duncathan/cs207proj/img/smashbox_schem.png

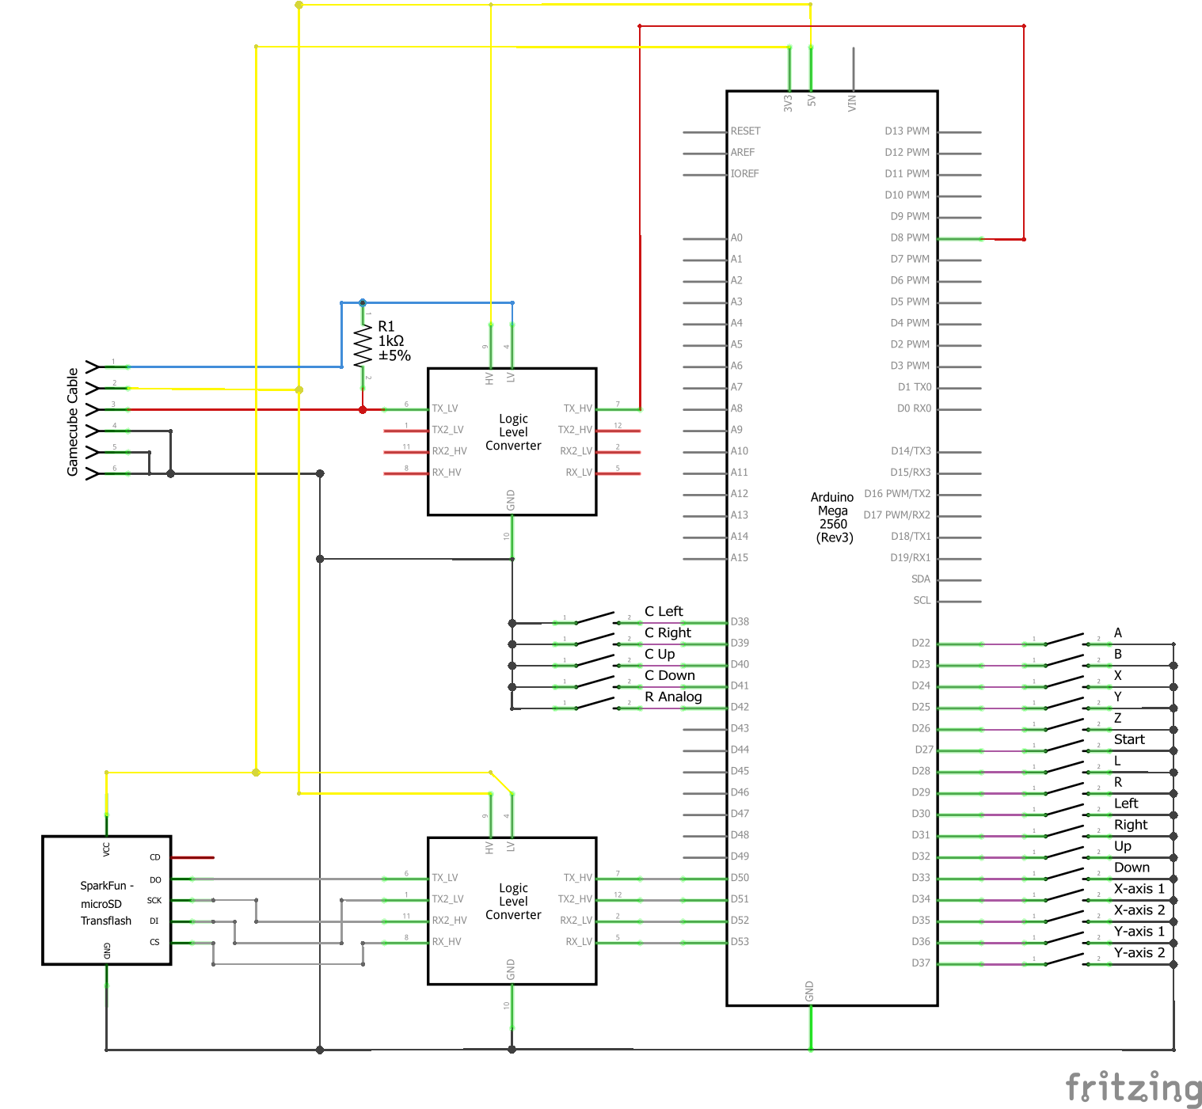
img/smashbox_schem.png
