duncathan/cs207proj/(list of files, drawings)

Other design files:
hardware/smashbox.fzz
