duncathan/cs207proj/hardware/eagle/sboxs.brd

## EAGLE design hardware/eagle/sboxs.brd (2018-03-08)

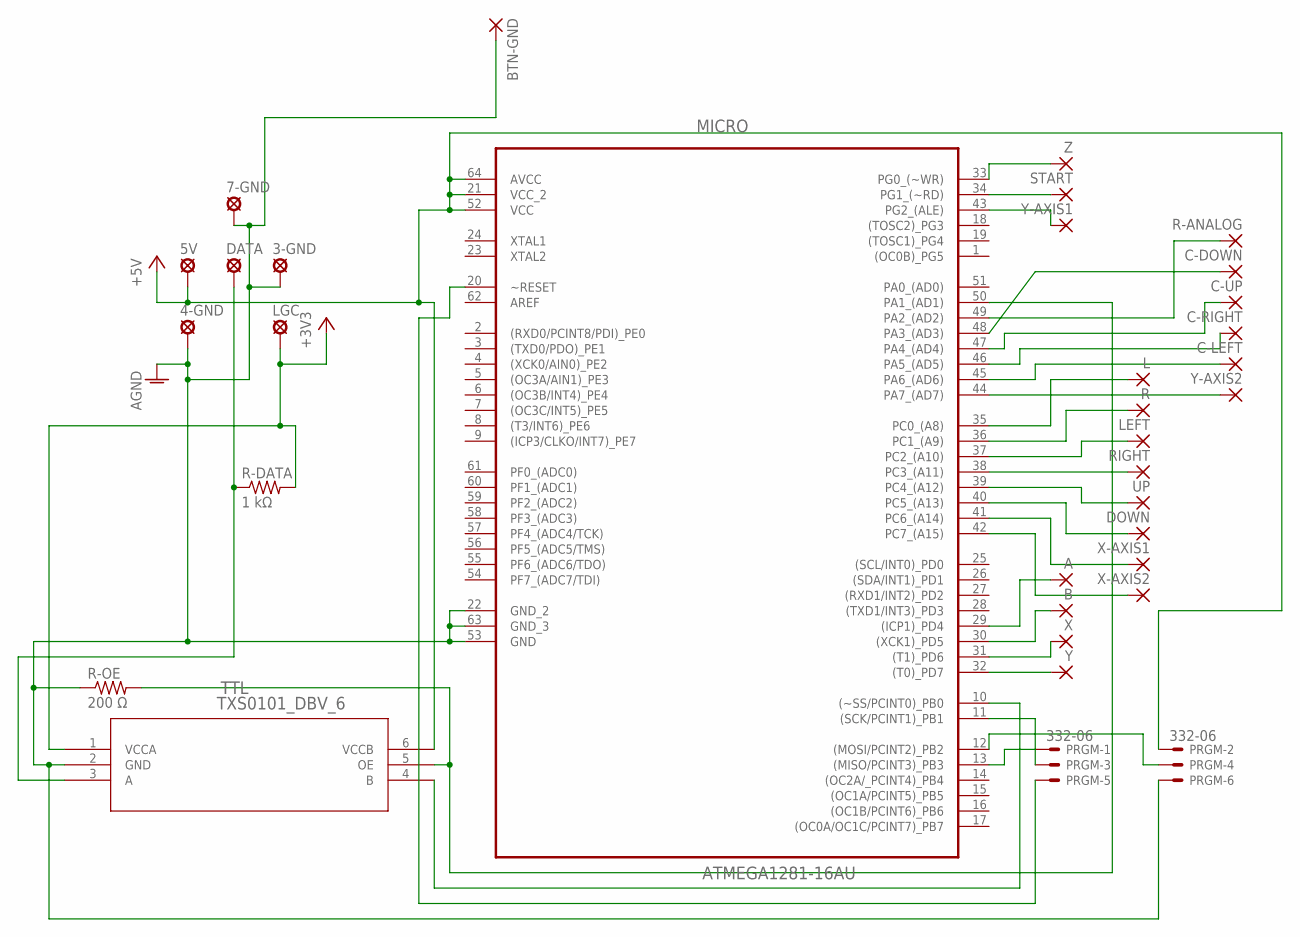
[picture p2: schematic sboxs.sch]

Parts:
3-GND, 4-GND, 5V, 7-GND: LSP10
A: 1,6/0,8
B: 1,6/0,8
BTN-GND: 1,6/0,8
C-DOWN: 1,6/0,8
C-LEFT: 1,6/0,8
C-RIGHT: 1,6/0,8
C-UP: 1,6/0,8
DATA: LSP10
DOWN: 1,6/0,8
L: 1,6/0,8
LEFT: 1,6/0,8
LGC: LSP10
MICRO: ATMEGA1281-16AU; QFP80P1600X1600X120-64N
PRGM: 332-06
R: 1,6/0,8
R-ANALOG: 1,6/0,8
R-DATA: 1 kΩ; 0207/12
R-OE: 200 Ω; 0207/12
RIGHT: 1,6/0,8
START: 1,6/0,8
TTL: TXS0101_DBV_6; DBV6
UP: 1,6/0,8
X: 1,6/0,8
X-AXIS1, X-AXIS2: 1,6/0,8
Y: 1,6/0,8
Y-AXIS1, Y-AXIS2: 1,6/0,8
Z: 1,6/0,8

Connections:
+3V3: LGC.MP, R-DATA.2, TTL.1 (VCCA)
+5V: 5V.MP, MICRO.21 (VCC_2), MICRO.52 (VCC), MICRO.64 (AVCC), PRGM.2, TTL.6 (VCCB)
AGND: 3-GND.MP, 4-GND.MP, 7-GND.MP, BTN-GND.1, MICRO.22 (GND_2), MICRO.53 (GND), MICRO.63 (GND_3), PRGM.6, R-OE.1, TTL.2 (GND)
unnamed: MICRO.32 ((T0)_PD7), Y.1
unnamed: MICRO.31 ((T1)_PD6), X.1
unnamed: B.1, MICRO.30 ((XCK1)_PD5)
unnamed: A.1, MICRO.29 ((ICP1)_PD4)
unnamed: MICRO.33 (PG0_(~WR)), Z.1
unnamed: MICRO.34 (PG1_(~RD)), START.1
unnamed: L.1, MICRO.35 (PC0_(A8))
unnamed: MICRO.36 (PC1_(A9)), R.1
unnamed: LEFT.1, MICRO.37 (PC2_(A10))
unnamed: MICRO.38 (PC3_(A11)), RIGHT.1
unnamed: MICRO.39 (PC4_(A12)), UP.1
unnamed: DOWN.1, MICRO.40 (PC5_(A13))
unnamed: MICRO.41 (PC6_(A14)), X-AXIS1.1
unnamed: MICRO.42 (PC7_(A15)), X-AXIS2.1
unnamed: MICRO.44 (PA7_(AD7)), Y-AXIS2.1
unnamed: C-LEFT.1, MICRO.45 (PA6_(AD6))
unnamed: C-RIGHT.1, MICRO.46 (PA5_(AD5))
unnamed: C-UP.1, MICRO.47 (PA4_(AD4))
unnamed: C-DOWN.1, MICRO.48 (PA3_(AD3))
unnamed: MICRO.49 (PA2_(AD2)), R-ANALOG.1
unnamed: MICRO.13 ((MISO/PCINT3)_PB3), PRGM.1
unnamed: MICRO.12 ((MOSI/PCINT2)_PB2), PRGM.4
unnamed: MICRO.11 ((SCK/PCINT1)_PB1), PRGM.3
unnamed: MICRO.43 (PG2_(ALE)), Y-AXIS1.1
unnamed: MICRO.20 (~RESET), PRGM.5
unnamed: DATA.MP, R-DATA.1, TTL.3 (A)
unnamed: MICRO.10 ((~SS/PCINT0)_PB0), TTL.4 (B)
unnamed: MICRO.50 (PA1_(AD1)), R-OE.2, TTL.5 (OE)

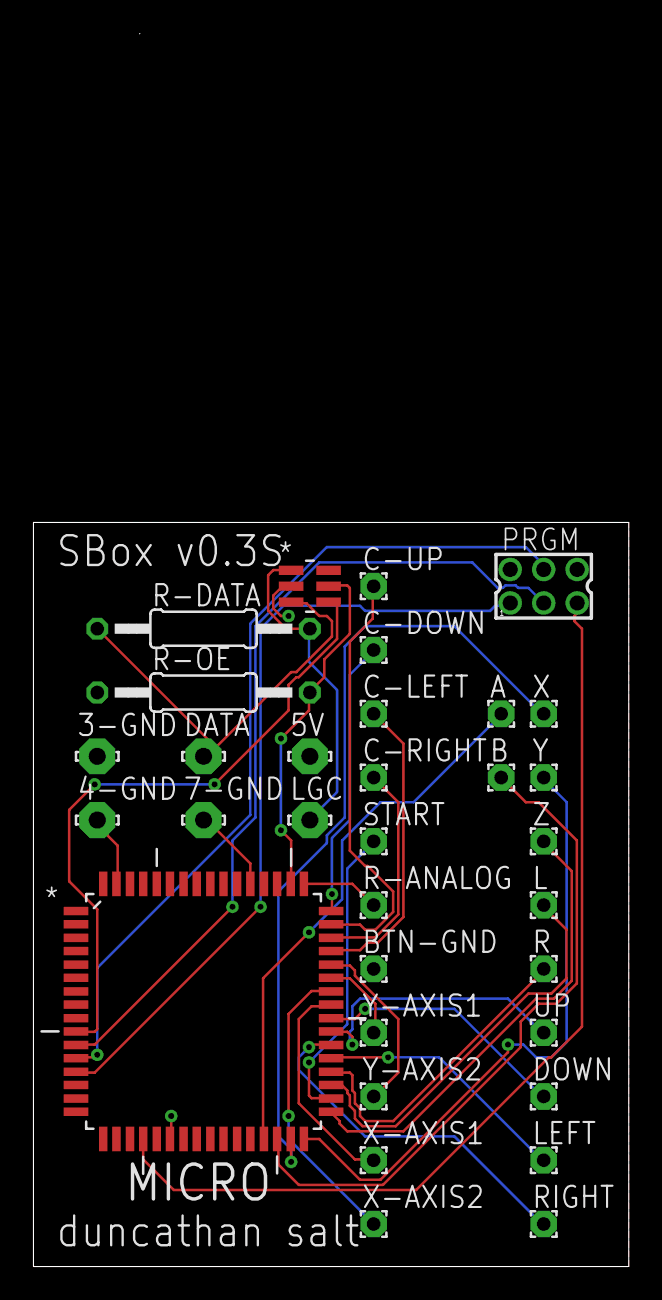
[picture p3: board sboxs.brd from above]

Board: 2 copper layers, 35.6 x 44.5 mm, 33 parts (0 on the bottom side), 31 nets.
