duncathan/cs207proj/(commit log)

2018-02-16 directory initialization
    [smashbox.fzz]
2018-03-04 first attempt at interfacing with the console
    just mashes the start button for now
    also included several defines for pinout/constants/etc
2018-03-08 add eagle schematic v0.2, large pcb diagram v0.2, small pcb diagram v0.3
    [sbox.brd, sbox.sch, sboxs.brd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]
2018-03-08 update to small pcb v0.2 and minor changes to overall schematic
    [sboxs.brd, sboxs.sch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]
2018-03-08 small pcb v0.3
2018-03-17 fix compile errors and additional minor improvements
    [smashbox.ino]
